KOBAKANT/SoundSamplePlayer/lucie_box_explanation.pdf

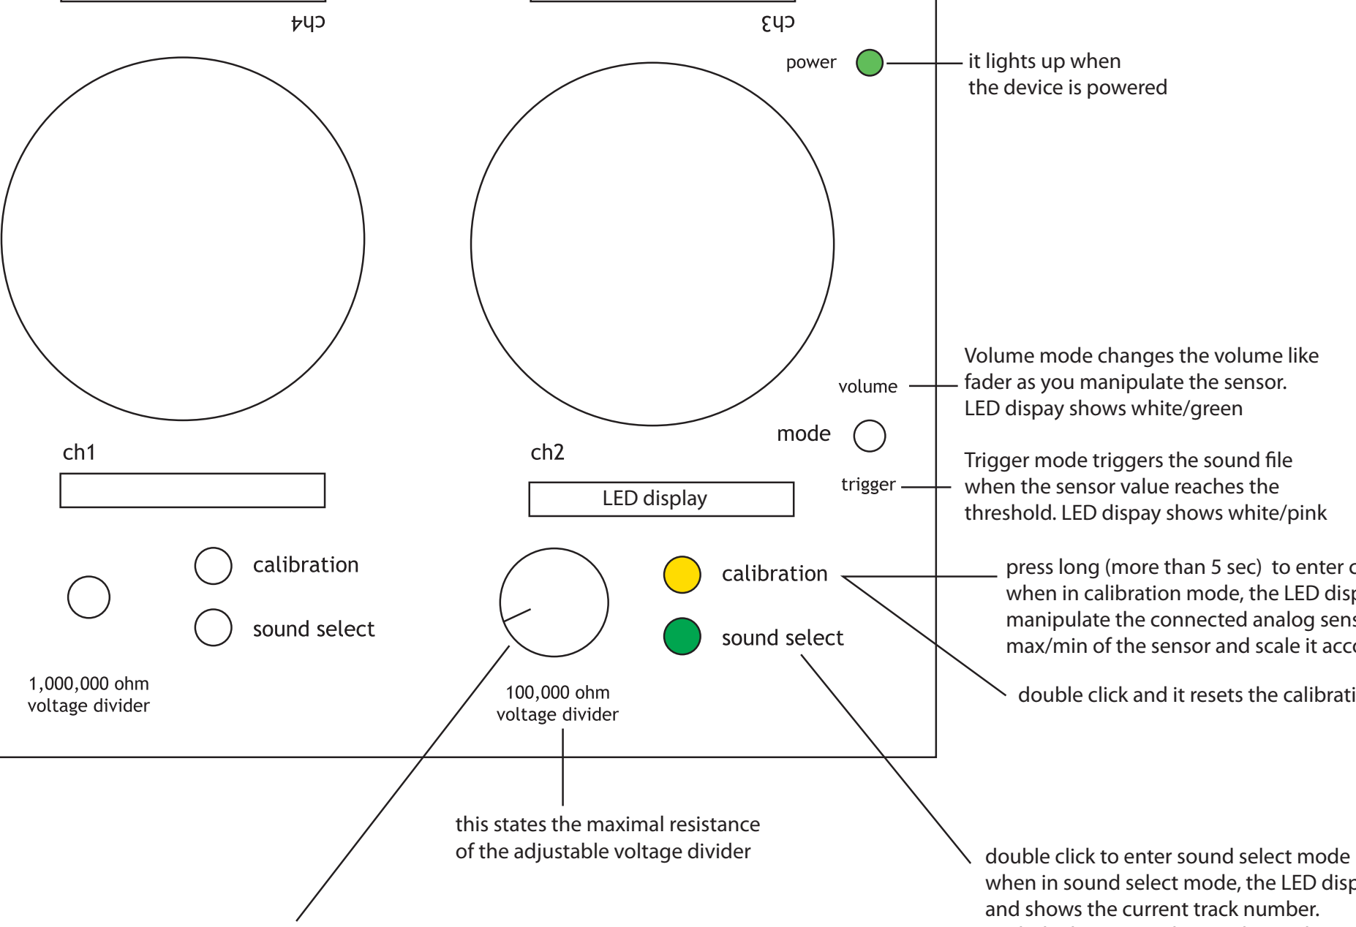
[picture p1: figure]
it lights up when the device is powered; Volume mode changes the volume like fader as you manipulate the sensor. LED dispay shows white/green; Trigger mode triggers the sound le when the sensor value reaches the threshold. LED dispay shows white/pink; this states the maximal resistance of the adjustable voltage divider; double click to enter sound select mode; and shows the current track number.; LED display

turn the knob to adjust the voltage divider value.
This will adjust the reading range of the connected analog sensor. After adjusting the voltage divider value, you can use the calibration mode to achieve full
range of reading.

press long (more than 5 sec) to enter calibration mode when in calibration mode, the LED display turns blue. manipulate the connected analog sensor so it sets max/min of the sensor and scale it accordingly

double click and it resets the calibration range

when in sound select mode, the LED display turns green

push the button to change the track number assigned to this channel. Times out after 5 seconds.
