KOBAKANT/SoundSamplePlayer/lucie_box_explanation.jpg

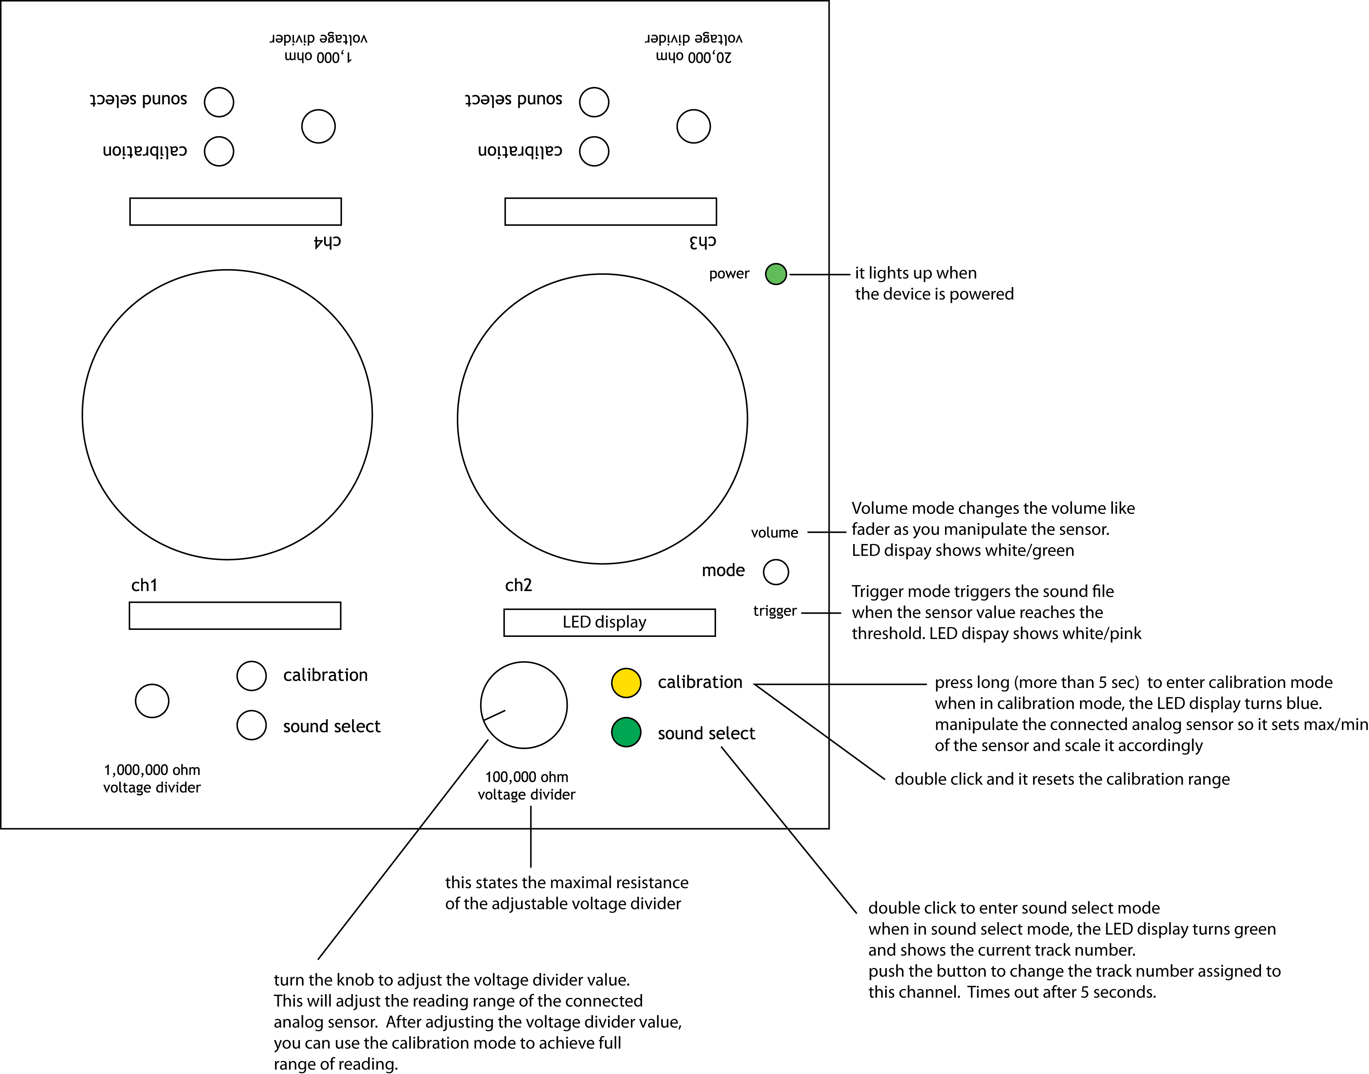
lucie_box_explanation.jpg
