KOBAKANT/SoundSamplePlayer/schematic.jpg

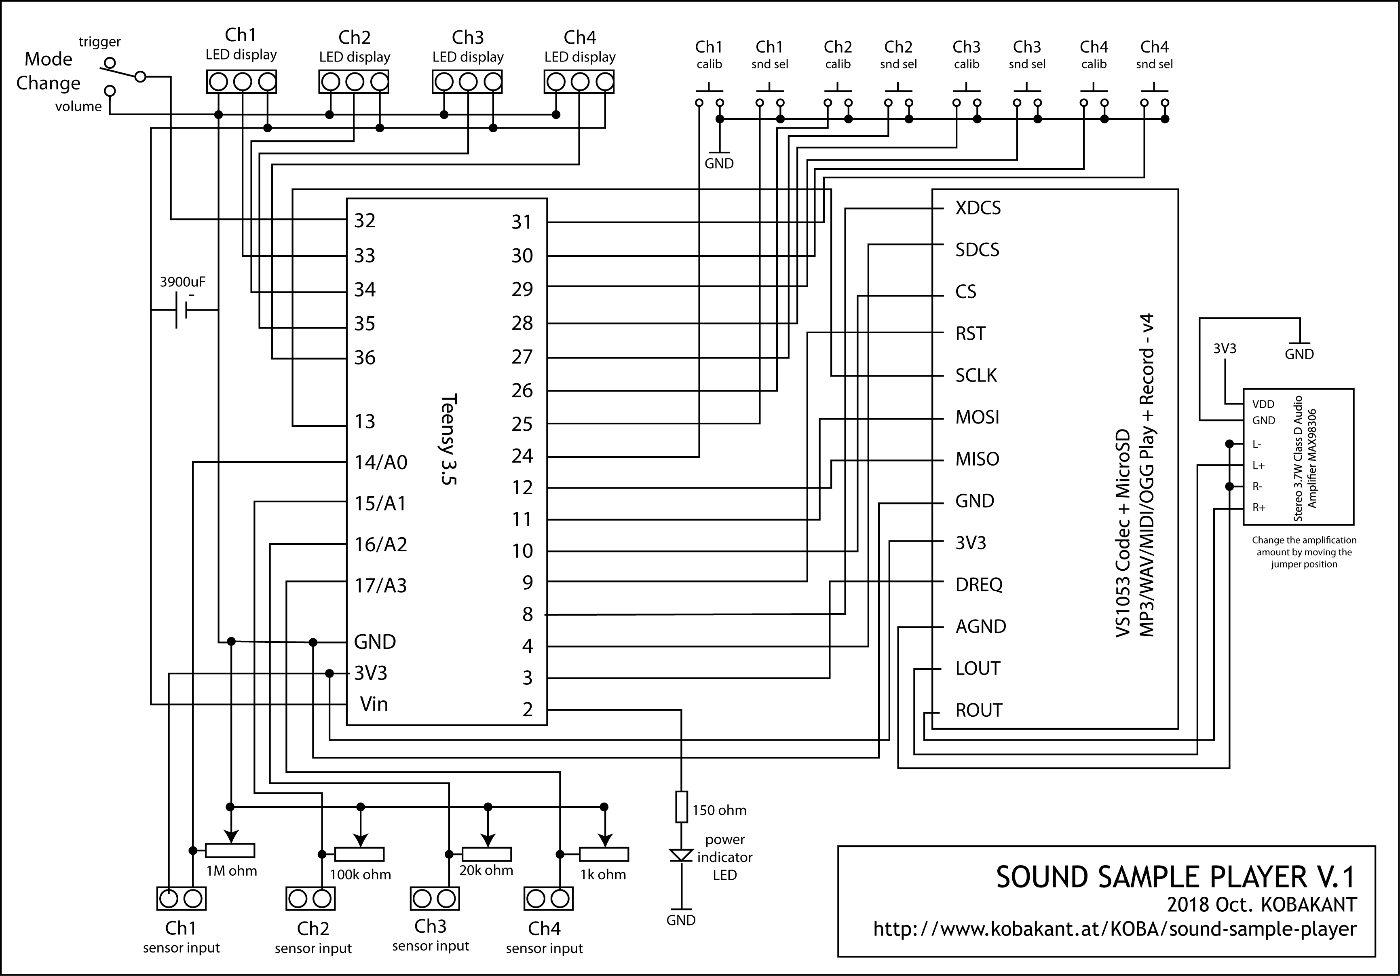
schematic.jpg
