KOBAKANT/SoundSamplePlayer/schematic.pdf

## XDCS

32

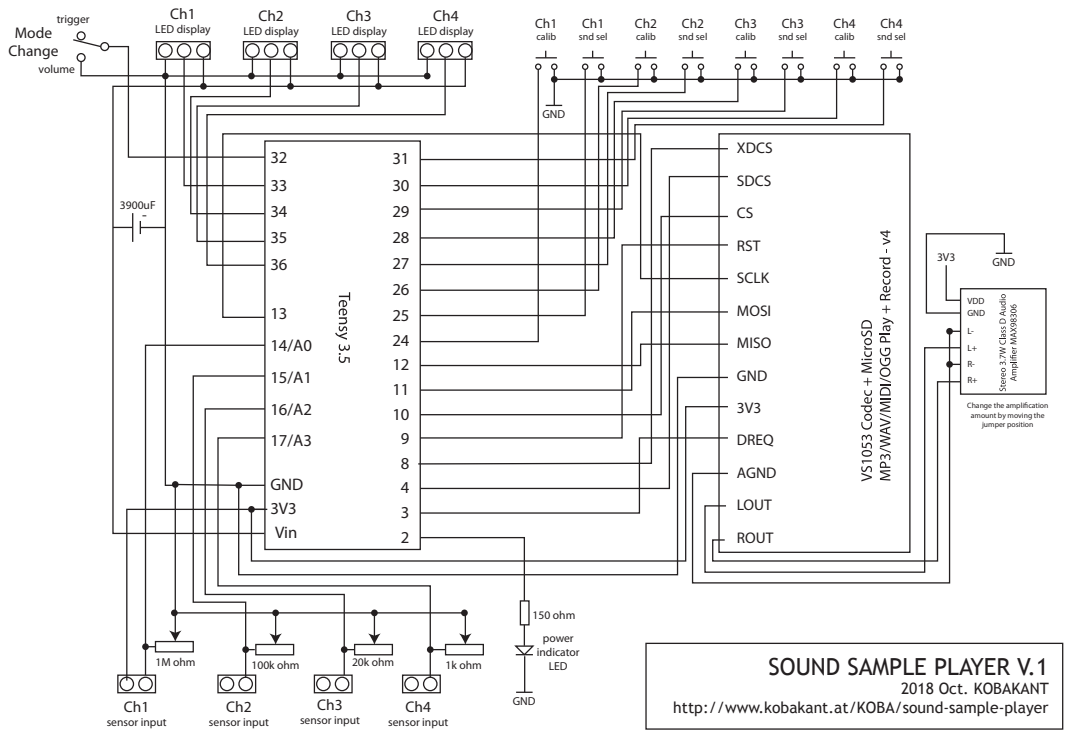
[picture p4: page 1]
SDCS; RST; SCLK; MOSI; MISO; GND; DREQ; AGND; LOUT; ROUT; Vin; VDD; 1M ohm; 100k ohm; 20k ohm; 1k ohm; 150 ohm; Ch1 sensor input; Ch2 sensor input; Ch3 sensor input; Ch4 sensor input; Mode; LED display; Change; Ch2 LED display; Ch3 LED display; Ch4 LED display; - ³⁹⁰⁰uF; Ch1 calib; Ch1 snd sel; Ch2 calib; Ch2 snd sel; Ch3 calib; Ch3 snd sel; Ch4 calib; Ch4 snd sel; volume; trigger; power indicator LED; GND 3V3; 2018 Oct. KOBAKANT

Change the amplication
amount by moving the
jumper position

SOUND SAMPLE PLAYER V.1

http://www.kobakant.at/KOBA/sound-sample-player
