KOBAKANT/SoundSamplePlayer/(commit log)

2018-10-18 schematic added
2018-10-18 material list added
